yangzepa/roomdisplay/hardware/README.md

# 하드웨어: 부품, 결선, 케이스

## 부품 목록

| 부품 | 사양 | 수량 | 비고 |
|---|---|---|---|
| MCU 보드 | TTGO T-Display 클론(Tenstar), **원조 ESP32**(S3 아님), 1.14" ST7789 LCD 내장 | 1 | LiPo 충전 회로, JST 1.25mm 2핀 배터리 커넥터, 전원 스위치 내장. 별도 충전 모듈 불필요 |
| e-paper | WeAct Studio 4.2" 흑/백/적 3색, 400×300, SSD1683(패널 E042A88) | 1 | GxEPD2 드라이버 `GxEPD2_420c_GDEY042Z98` |
| 배터리 | LiPo 1셀 3.7V, **3500mAh**(현재) | 1 | JST 1.25mm 2핀. 처음 쓴 셀(라벨 2.07Wh)은 실제 용량이 약 200mAh로 추정됨 |
| 자석 | 원형 네오디뮴 Ø10 × 3mm | 4–6 | 철문 부착용. 뒷판 바깥면 포켓에 넣음 |
| 연결선 | 듀폰 암 점퍼 | 8 | 헤더 핀을 바깥으로 꺾어 체결(납땜 없음) |
| 나사 | **M2 태핑 나사 6–8mm** | 4 | 케이스 앞판과 뒷판 고정. 없으면 글루건으로 대체 가능 |
| 케이스 | 3D 프린트(PLA) 본체 + 뒷판 | 1세트 | [`case/`](case) |
| 서버 | Docker가 도는 리눅스 PC 아무거나 | 1 | 문패와 같은 LAN |
| 공유기 | 2.4GHz WPA2/WPA3(사용 중: TP-Link Archer BE230) | 1 | ESP32는 2.4GHz만 지원 |

자동 상태 전환(선택)에는 라즈베리파이 + 카메라(Frigate 사람 감지)와 구글 캘린더를 씁니다.

## 결선

T-Display의 윗줄 헤더 한쪽으로 모았습니다.

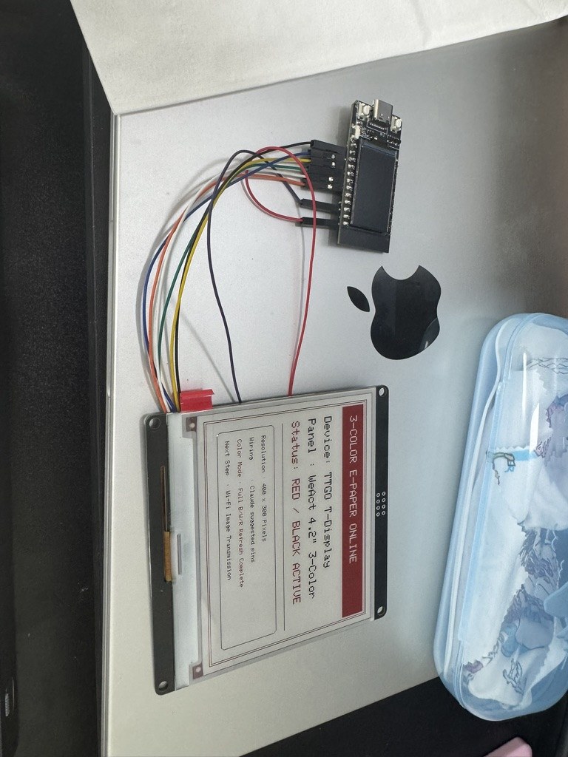
[picture p18: docs/images/photos/wiring-test.jpg]
결선 테스트


케이스에 넣기 전 결선 확인입니다. 헤더 핀을 바깥으로 꺾어 듀폰 암 점퍼로 연결했고, e-paper에는 테스트 화면이 떠 있습니다.

| e-paper 핀 | T-Display GPIO | 비고 |
|---|---|---|
| VCC | 3V | |
| GND | G | |
| SDA(MOSI) | 26 | |
| SCL(SCK) | 25 | |
| CS | 27 | |
| D/C | 33 | |
| RES | 32 | |
| BUSY | 37 | 입력 전용 핀 |

- **SPI 재매핑**: `SPI.begin(25, -1, 26, -1)` 다음 `display.init(115200, true, 50, false)`, `setRotation(0)`(400×300 가로)
- **사용 금지 핀**:
  - 온보드 LCD: 18, 19, 5, 16, 23, 4(백라이트)
  - 스트래핑: 0, 2, 12, 15. BUSY를 GPIO2에 두면 업로드할 때마다 리셋 버튼이 필요했음.
- **배터리 전압**: GPIO34(ADC, 1/2 분압). 측정할 때만 GPIO14(ADC_EN)를 HIGH로 둡니다. 클론 보드에서도 동작 확인.
- **LCD 백라이트**: 부팅 직후 GPIO4를 LOW로 두고 LCD는 초기화하지 않습니다(절전).
- **e-paper 확인**: 결선만 확인할 때는 [`test_epaper.ino`](test_epaper.ino)를 Arduino IDE로 올립니다.

## 케이스 (3D 프린트)

| 파일 | 내용 |
|---|---|
| [`case/epaper_door_case.scad`](case/epaper_door_case.scad) | OpenSCAD 파라메트릭 원본. `part = "shell" \| "cover" \| "assembly"` |
| [`case/shell.stl`](case/shell.stl) | 본체(앞판 + 측벽) |
| [`case/cover.stl`](case/cover.stl) | 뒷판(자석 포켓, 배터리·T-Display 가이드). Y 미러 처리되어 있음 |

STL은 GitHub에서 바로 3D 미리보기가 됩니다.

- **외형**: 약 101 × 99 × 18.5mm
- **본체**:
  - 표시 창(바깥쪽 45° 모따기)
  - 기판 받침 턱
  - 오른쪽 벽 USB-C 구멍
  - 모서리 M2 나사 구멍
- **뒷판**:
  - 바깥면 자석 포켓
  - 안쪽 배터리 울타리, T-Display 가이드, 기판 누름 기둥
- **출력**: 본체는 앞면, 뒷판은 바깥면을 베드에 두고 서포트 없이 출력합니다.
- **치수 근거**:
  - WeAct 보드 외형도(기판 91.8×89.8, 장착홀 가장자리 2.8mm, Ø2.8)
  - 패널 사양서(외곽 91×77×1.15, 표시 영역 84.8×63.6)
  - 실측(92×89)
- `[MEASURE]` 표시가 있는 값은 캘리퍼로 실측해 고쳐야 합니다.

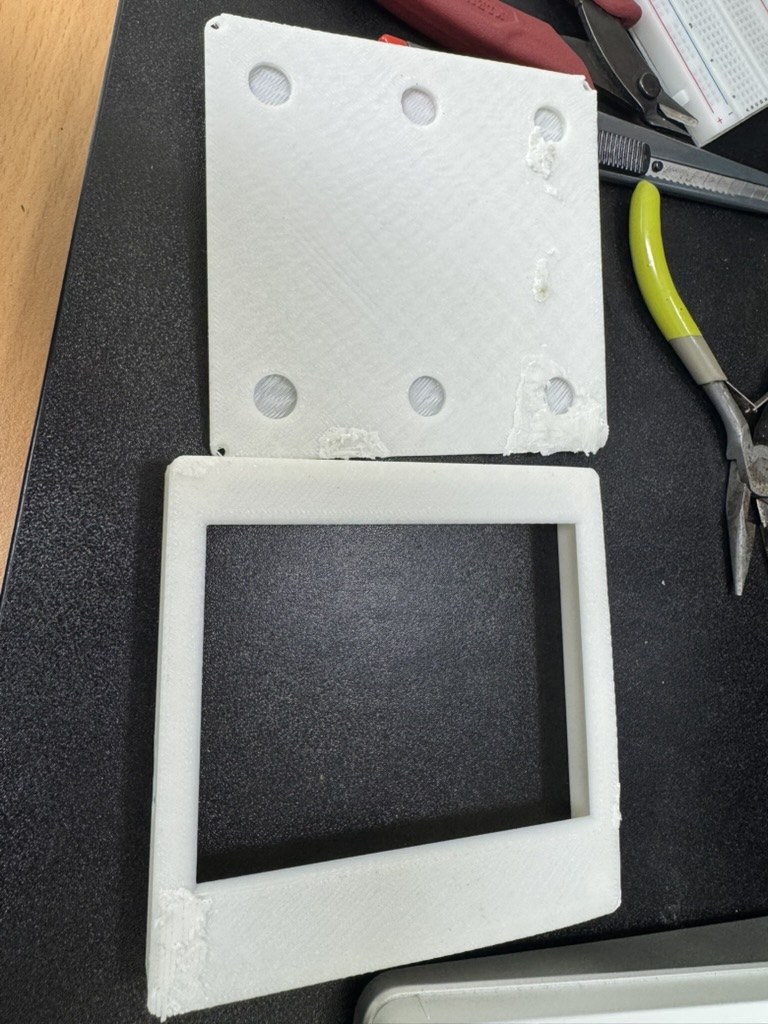
[picture p19: docs/images/photos/case-parts.jpg]
출력한 케이스 뒷판과 본체


출력한 뒷판(자석 포켓 6개)과 본체입니다. 모서리의 하얀 덩어리는 나사 대신 글루건으로 고정한 흔적입니다.

### 알려진 문제와 개정할 점

- **결선 변경 미반영**: 케이스는 예전 결선(아래 줄 7개 + 37번) 기준으로 듀폰 공간을 잡았습니다. 지금은 윗줄 한쪽으로 모았으니 T-Display 위치와 가이드를 다시 배치해야 합니다.
- **배터리 치수**: 설계는 603450(54×35×6.5mm) 기준입니다. 3500mAh 셀을 쓰면 `bat_w/bat_h/bat_t`와 `comp_d`를 실측값으로 바꿔야 합니다.
- **고정**:
  - 큰 배터리 무게로 앞판과 뒷판이 벌어졌습니다.
  - 배터리를 **뒷판(자석 쪽)에 양면 폼테이프로 붙여** 무게가 바로 자석에 실리게 하고, 모서리를 M2 태핑 나사나 글루건으로 고정했습니다.
  - 리튬 셀이 부풀 수 있으니 완전히 밀봉하지는 않습니다.
- **WiFi**:
  - 철문에 붙이면 보드 PCB 안테나가 철판에 가려 신호가 크게 떨어집니다(문밖 RSSI -75~-85dBm).
  - 안테나 쪽(USB-C 반대쪽 끝)을 위로 두고 철판에서 조금이라도 띄우는 구조가 좋습니다.
  - 다음 개정에서 스페이서를 넣는 것을 검토 중입니다.
- **전원 스위치**: T-Display 전원 스위치가 케이스 안쪽을 향해 밖에서 조작할 수 없습니다. ON으로 고정해 씁니다.
