yangzepa/roomdisplay/docs/images/epaper/exercise.png

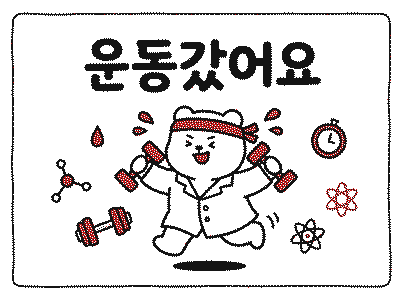
docs/images/epaper/exercise.png
