yangzepa/roomdisplay/docs/images/epaper/seminar.png

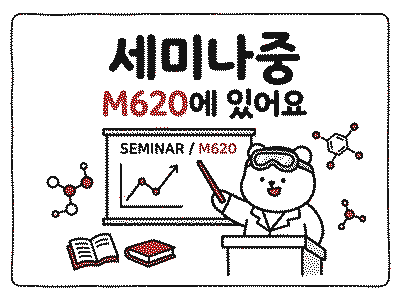
docs/images/epaper/seminar.png
