yangzepa/roomdisplay/hardware/case-v2/stl/front_v2.stl

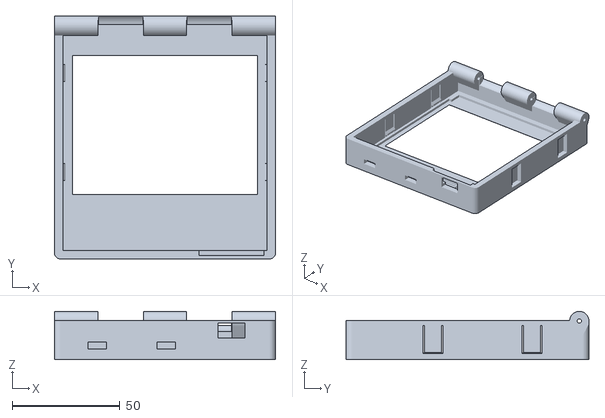
[picture p28: CAD file, 2026-10-25]
hardware/case-v2/stl/front_v2.stl
103.0 x 113.0 x 22.4
