yangzepa/roomdisplay/hardware/case-v2/stl/cover_v2.stl

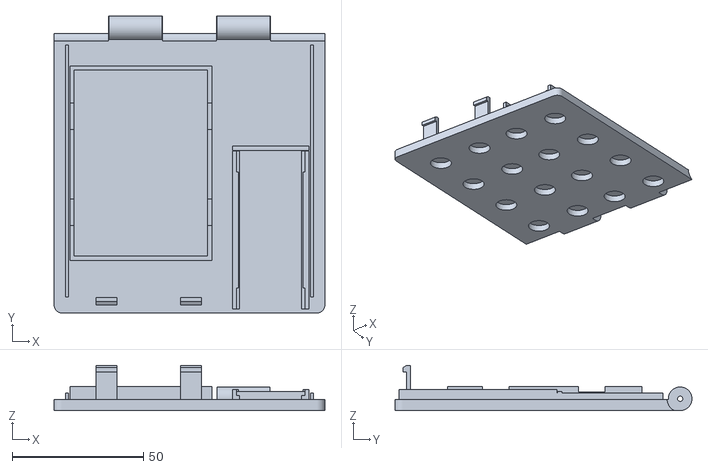
[picture p29: CAD file, 2026-10-25]
hardware/case-v2/stl/cover_v2.stl
103.0 x 113.0 x 17.2
