yangzepa/roomdisplay/hardware/case/cover.stl

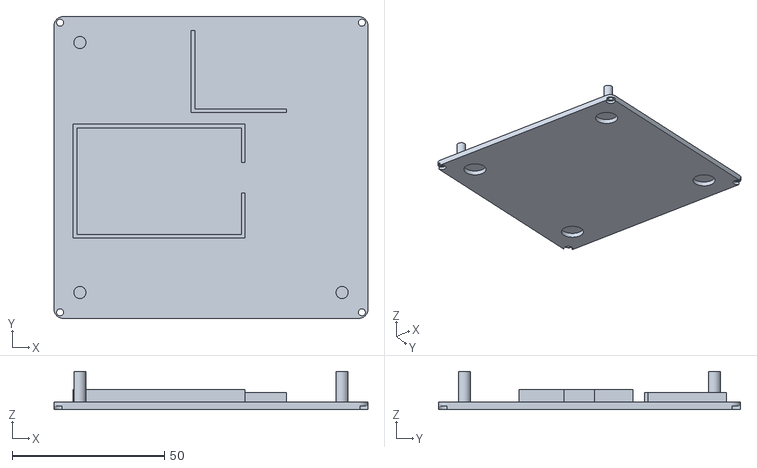
[picture p30: CAD file, 2026-10-13, an earlier design]
hardware/case/cover.stl
103.0 x 99.0 x 12.6
