yangzepa/roomdisplay/hardware/case/shell.stl

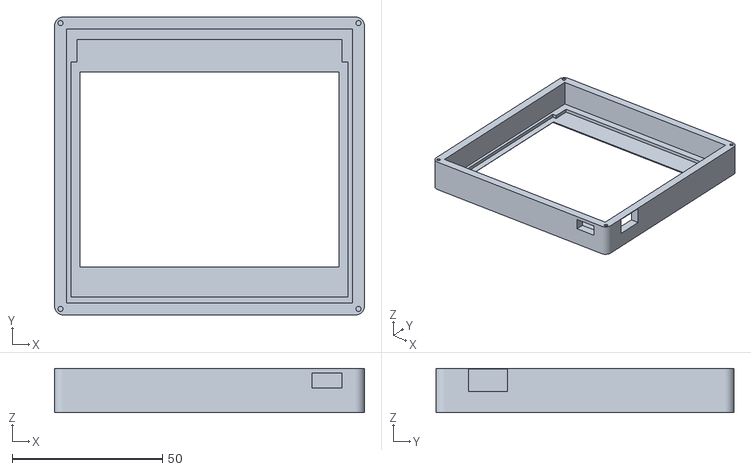
[picture p31: CAD file, 2026-10-13, an earlier design]
hardware/case/shell.stl
103.0 x 99.0 x 14.8
