yangzepa/roomdisplay/(list of files, cad)

Other CAD files:
hardware/case/epaper_door_case.scad
