yangzepa/roomdisplay/firmware/include/secrets.example.h

#pragma once
// secrets.h 로 복사한 뒤 값을 채우세요. (secrets.h 는 커밋하지 않음)
#define WIFI_SSID   "YOUR_SSID"            // 2.4GHz, 대소문자 정확히
#define WIFI_PASS   "YOUR_PASSWORD"
#define SERVER_BASE "http://192.168.0.10:8070"   // 서버(도커 호스트)의 LAN 주소
