yangzepa/roomdisplay/(commit log)

2026-10-13 연구실 e-paper 문패: 서버, 펌웨어, 하드웨어, 운용 기록
    - server: FastAPI + Pillow 문패 서버(Docker). 그림을 400x300 3색으로 변환하고,
    상태별 그림 연결, 같은 그림이면 갱신 생략, 배터리·충전 추정, 이벤트 기록, 웹 UI
    - firmware: ESP32 T-Display. arduino+espidf 자동 라이트슬립, 55초 롱폴링,
    자가 복구(WiFi 재연결, 무응답 시 재부팅), 진단값 보고
    - hardware: 부품 목록, 결선, OpenSCAD/STL 케이스, e-paper 동작 확인 스케치
    - docs: 전력 최적화와 배터리 보정 기록, 원시 배터리 로그, 일러스트, 초기 설계 문서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
    [battery_raw.csv, cover.stl, epaper_door_case.scad, shell.stl]
2026-10-13 실물 사진 추가: 문에 부착한 모습, 결선 테스트, 케이스 부품
    - 문 전경 사진의 명패(이름·학과·호실·시간표)는 흐림 처리
    - 모든 사진의 EXIF(GPS 위치 포함) 제거
2026-10-25 케이스 2.0 설계: 힌지·스냅 잠금, 자석 16개, 외부 안테나 칸
    - 전면 표시부는 1.0 실측 치수 유지, e-paper는 옆벽 스냅 탭 4개로 고정
    - 위쪽 5마디 힌지(1.75mm 필라멘트 핀), 아래쪽 스냅 훅 2개로 잠금
    - 뒷판 자석 Ø10x3 포켓 16개, 보드(FireBeetle 2 ESP32-C5-U)·배터리는 뒷판에 장착
    - 표시부 아래 안테나 칸(FPC 안테나를 철판에서 약 21mm 떨어진 앞면 안쪽에)
    - 겹침·열림 간섭 검사, 출력용 STL, 미리보기 렌더러(numpy+Pillow)
    [cover_v2.stl, front_v2.stl, roomdisplay_case_v2.scad]
